RootCubed/CALCKS/Paper/assets/060306 015b (10).jpg

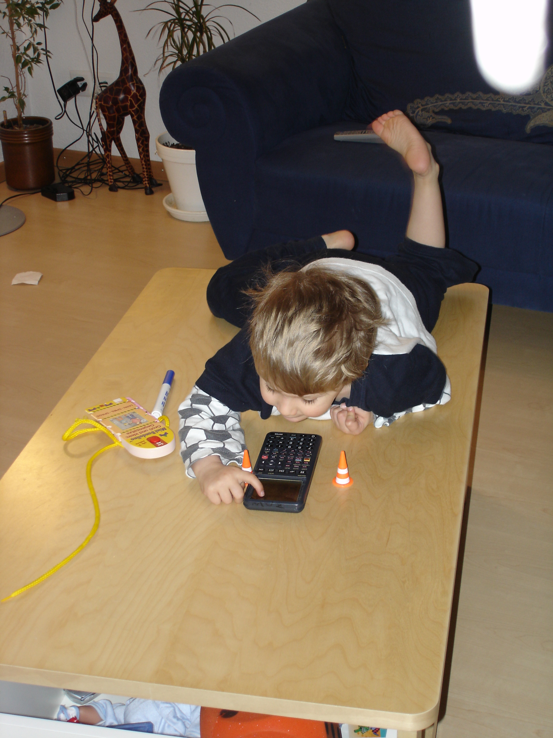
Paper/assets/060306 015b (10).jpg
