RootCubed/CALCKS/Paper/assets/background.jpg

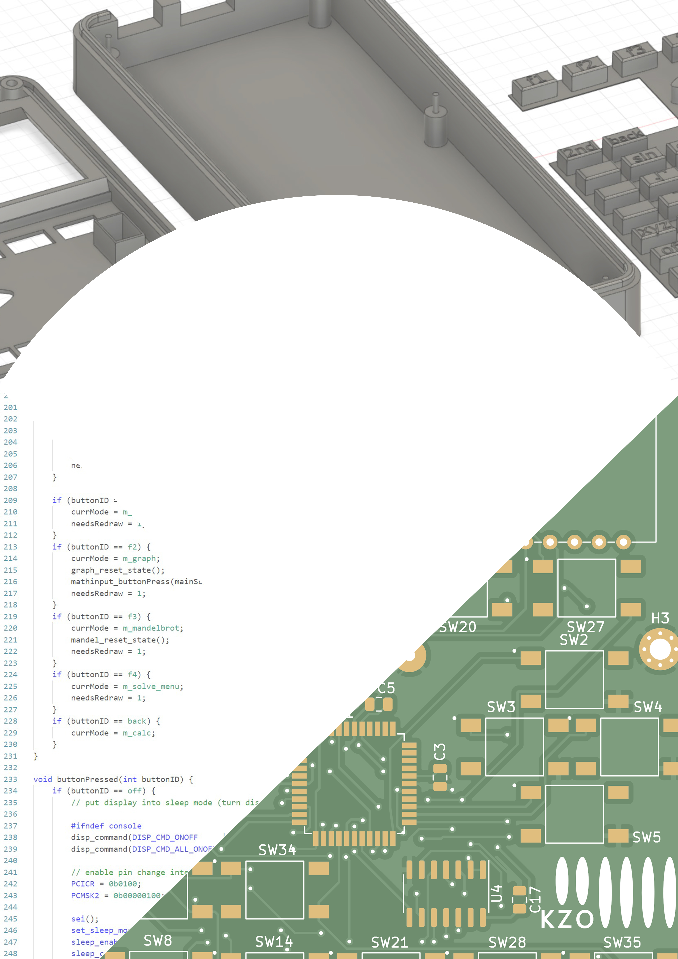
Paper/assets/background.jpg
