RootCubed/CALCKS/Paper/assets/breadboard.jpg

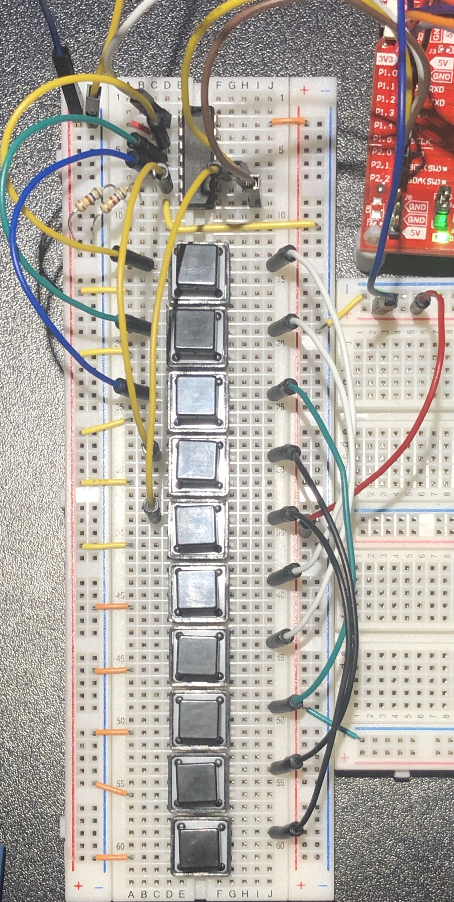
Paper/assets/breadboard.jpg
