RootCubed/CALCKS/Paper/assets/calc_example_calculation_l.png

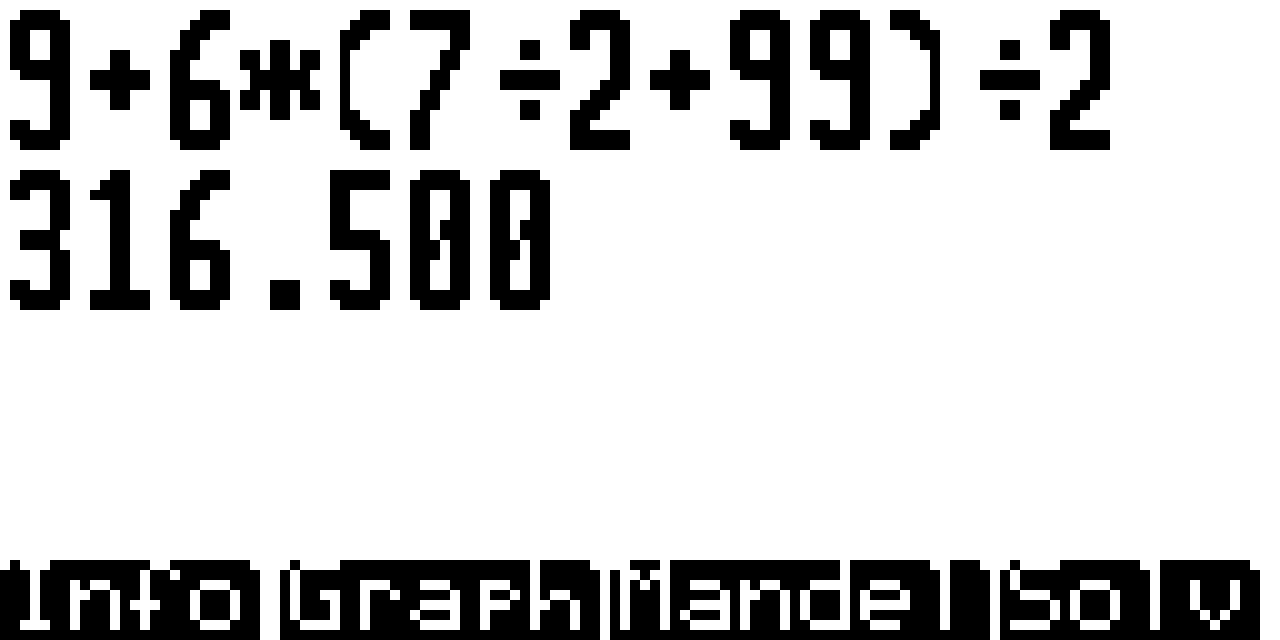
Paper/assets/calc_example_calculation_l.png
