RootCubed/CALCKS/Paper/assets/dogm128.png

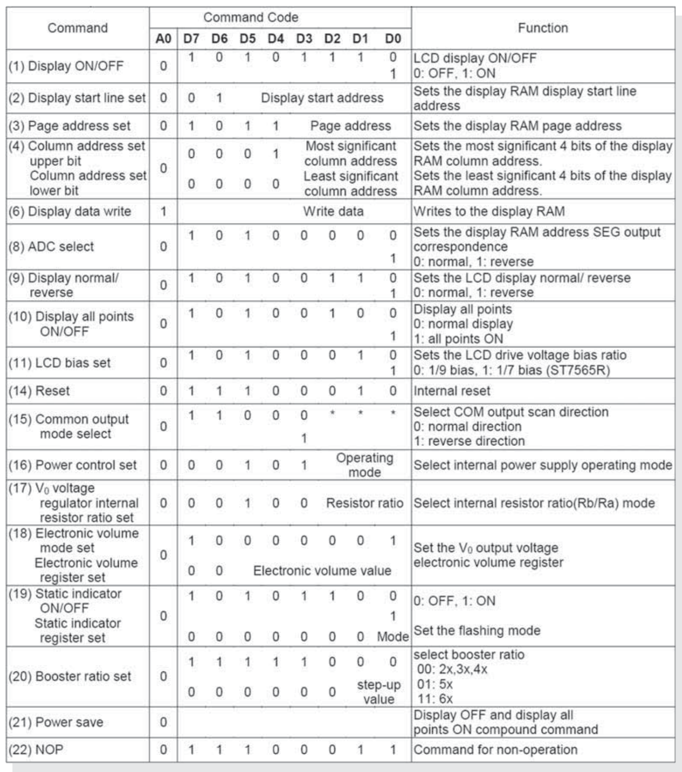
Paper/assets/dogm128.png
