RootCubed/CALCKS/Paper/assets/IMG_5603.JPG

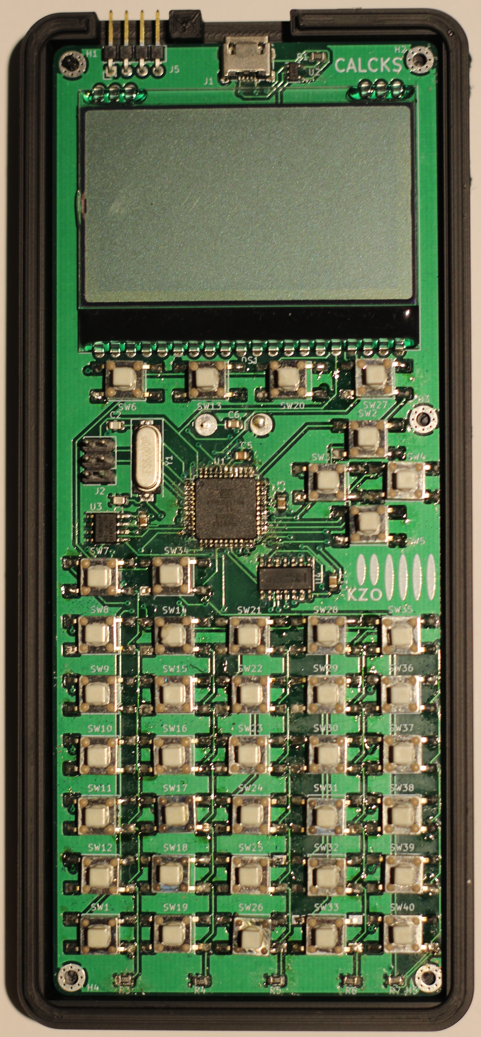
Paper/assets/IMG_5603.JPG
