RootCubed/CALCKS/Paper/assets/IMG_5605.JPG

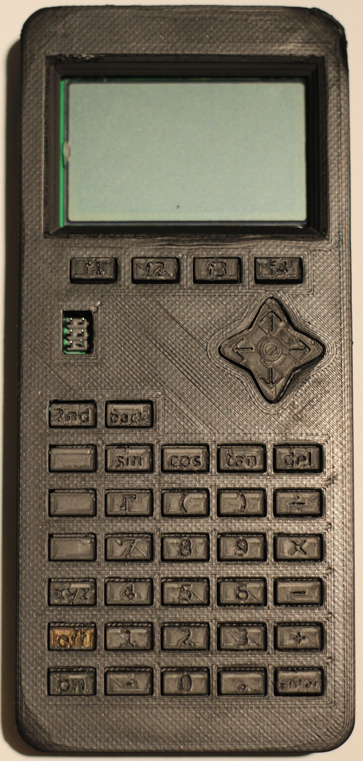
Paper/assets/IMG_5605.JPG
