RootCubed/CALCKS/Paper/assets/Screenshot 2020-10-16 181640.jpg

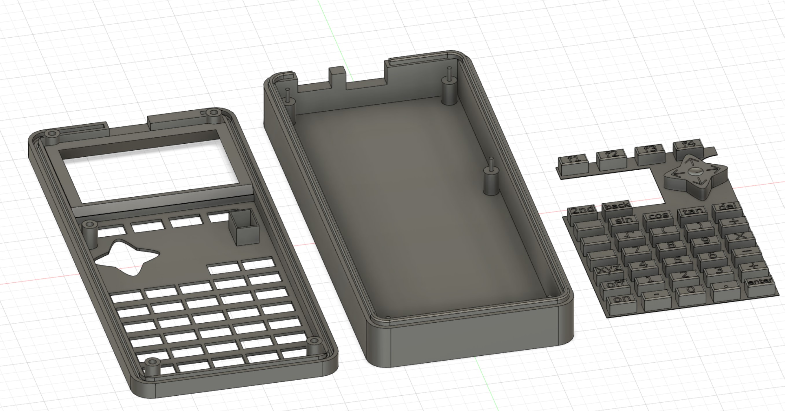
Paper/assets/Screenshot 2020-10-16 181640.jpg
