RootCubed/CALCKS/Paper/assets/screenshotvscode.jpg

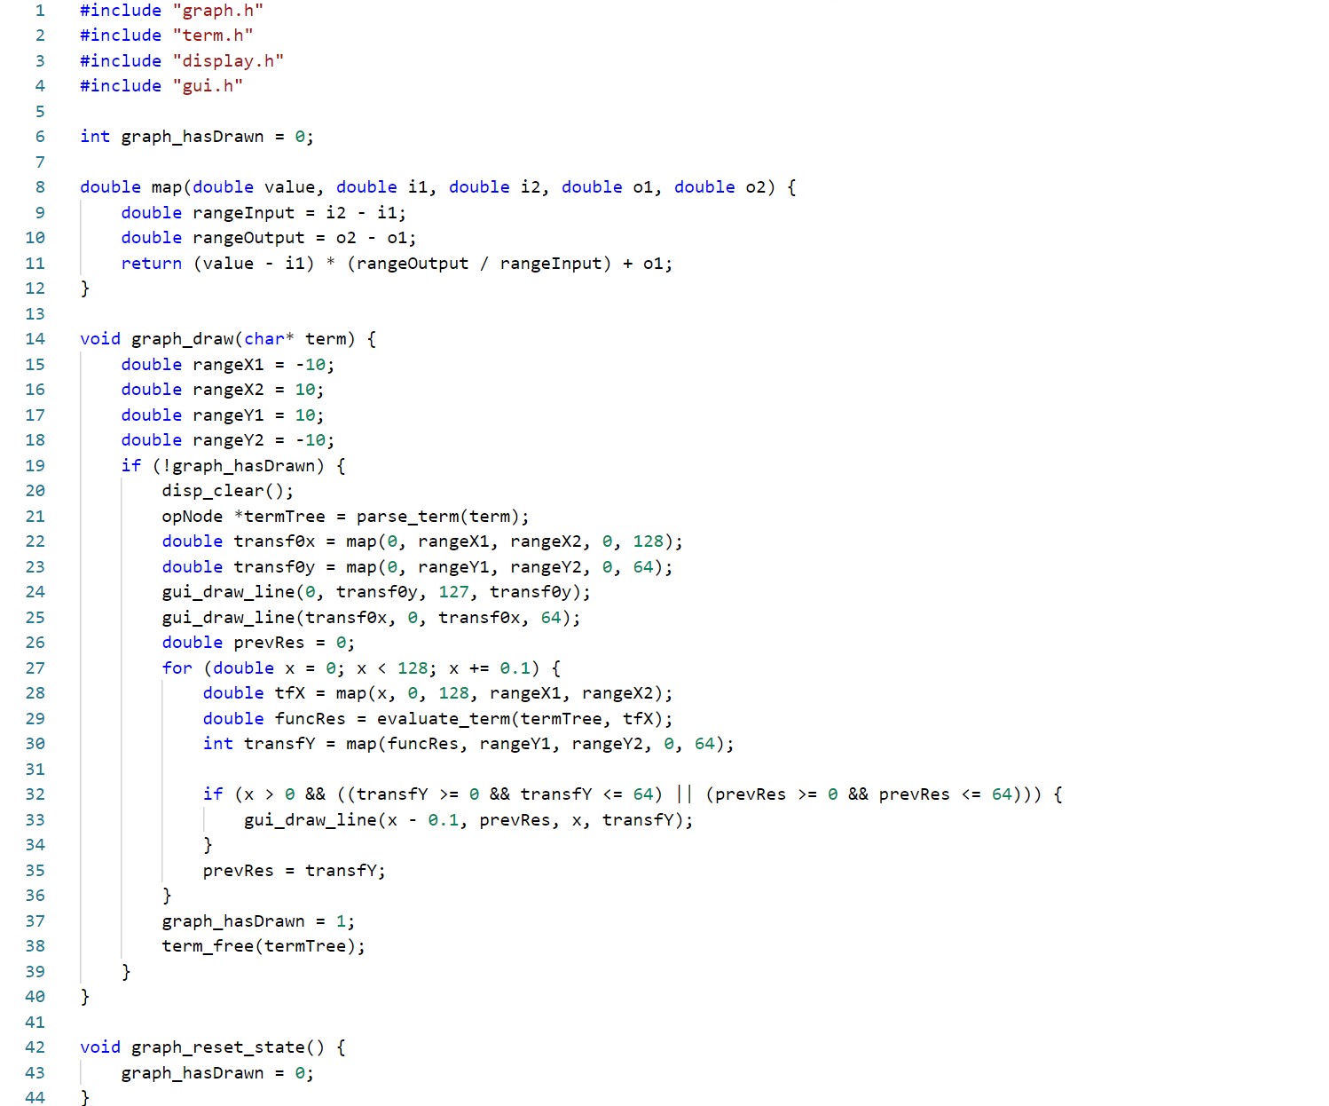
Paper/assets/screenshotvscode.jpg
