RootCubed/CALCKS/Paper/assets/vscodescreen2.jpg

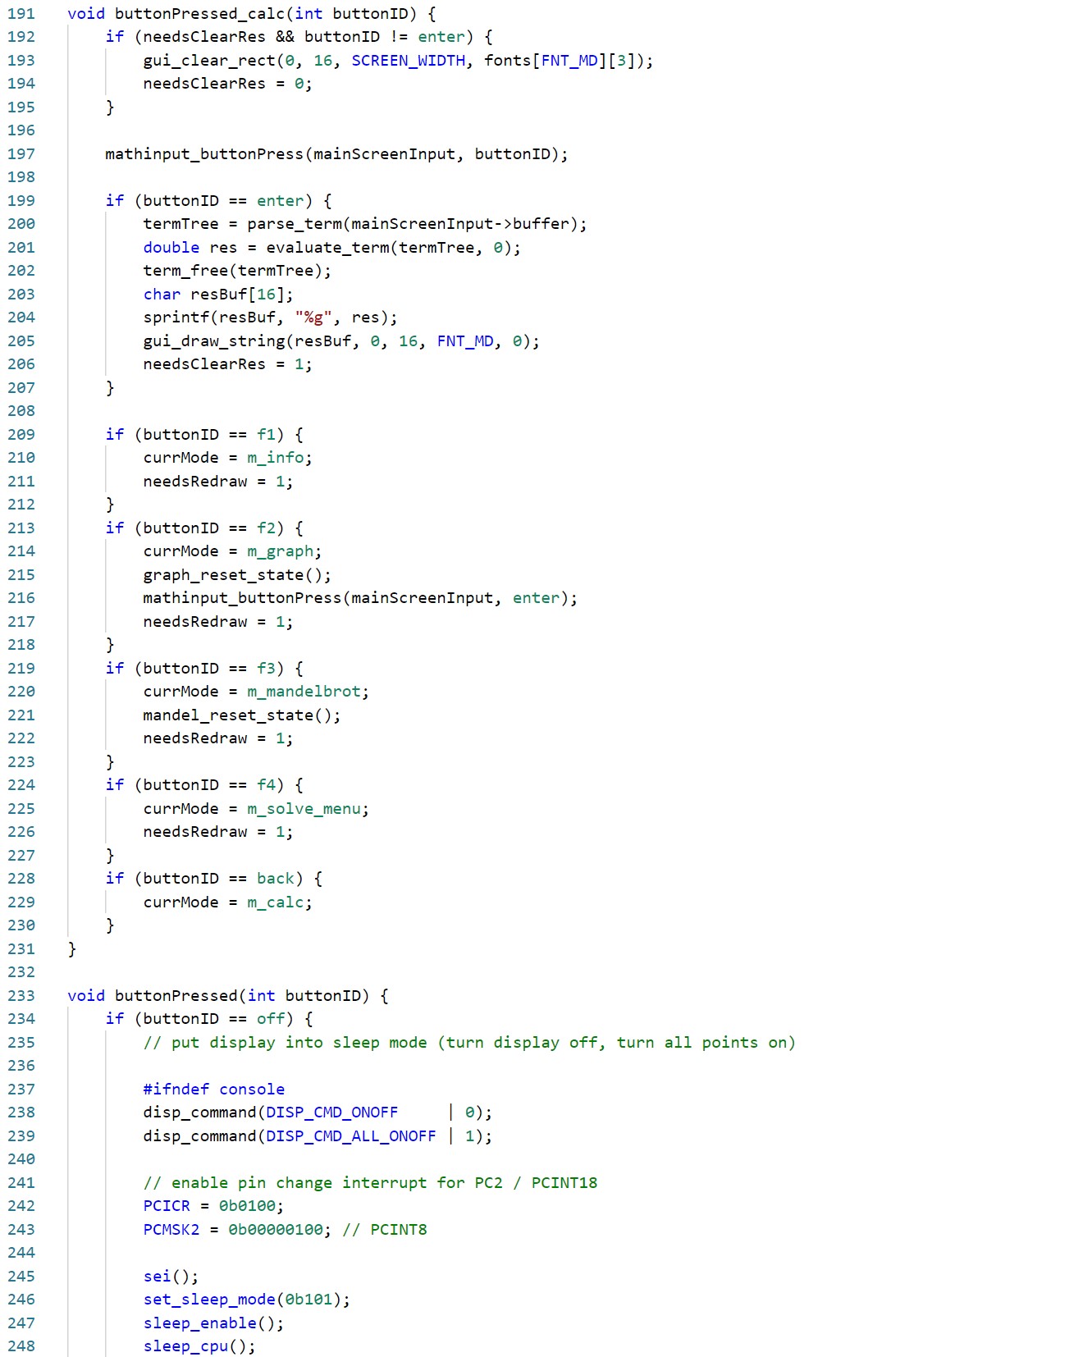
Paper/assets/vscodescreen2.jpg
