RootCubed/CALCKS/Hardware/3D Models/C_Top.stl

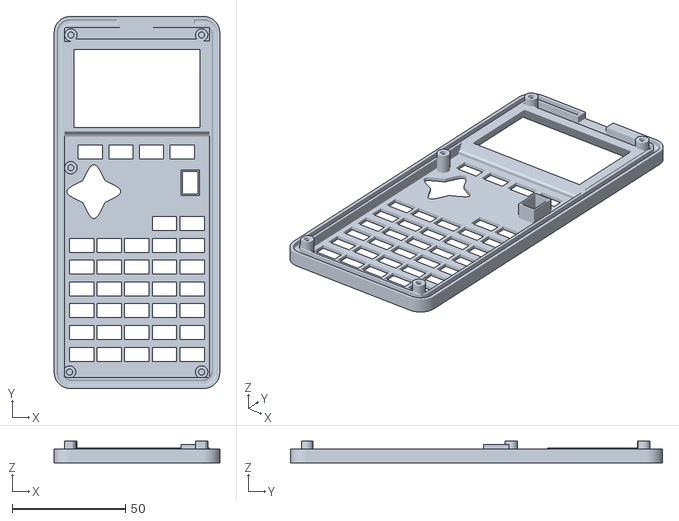
[picture p43: CAD file, 2020-11-02]
Hardware/3D Models/C_Top.stl
73.0 x 164.0 x 9.50
