RootCubed/CALCKS/Hardware/CALCKS/Downloaded Footprints/TL3301SPFxxxxG.stp

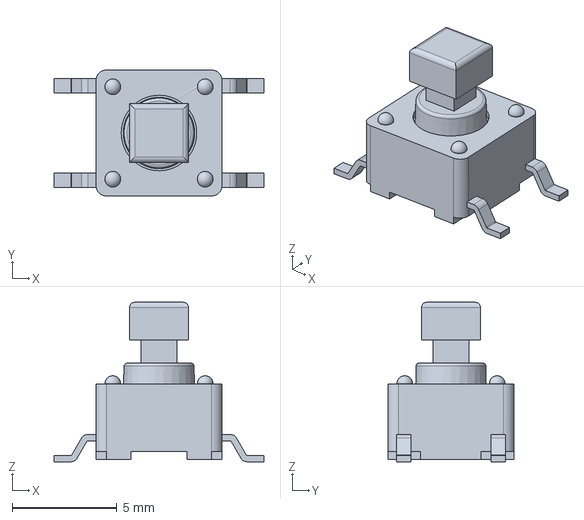
[picture p44: CAD file, 2020-06-26]
Hardware/CALCKS/Downloaded Footprints/TL3301SPFxxxxG.stp
10.0 x 6.00 x 7.60 mm
