RootCubed/CALCKS/Hardware/3D Models/C_Button_Pressers.stl

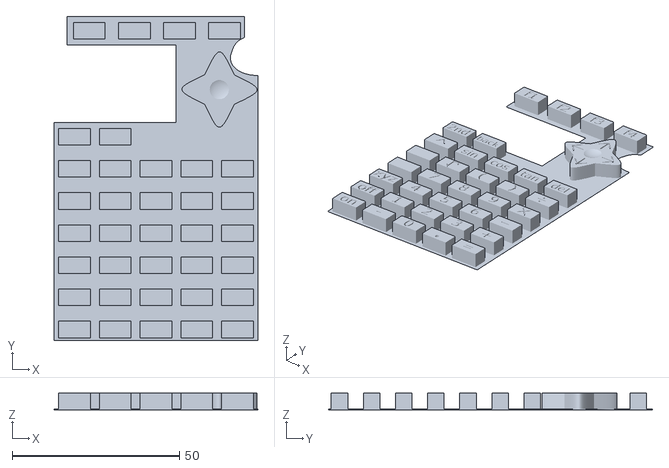
[picture p45: CAD file, 2020-11-02]
Hardware/3D Models/C_Button_Pressers.stl
60.8 x 96.8 x 5.00
