RootCubed/CALCKS/Hardware/3D Models/C_Bottom.stl

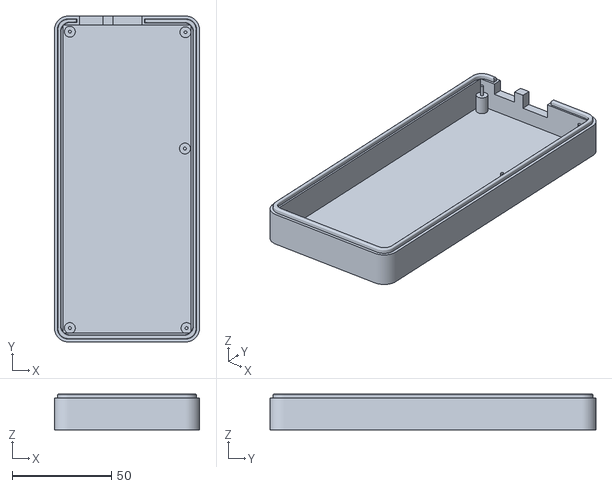
[picture p46: CAD file, 2020-11-02]
Hardware/3D Models/C_Bottom.stl
73.0 x 164.0 x 18.0
