RootCubed/CALCKS/Paper/assets/schematic.pdf

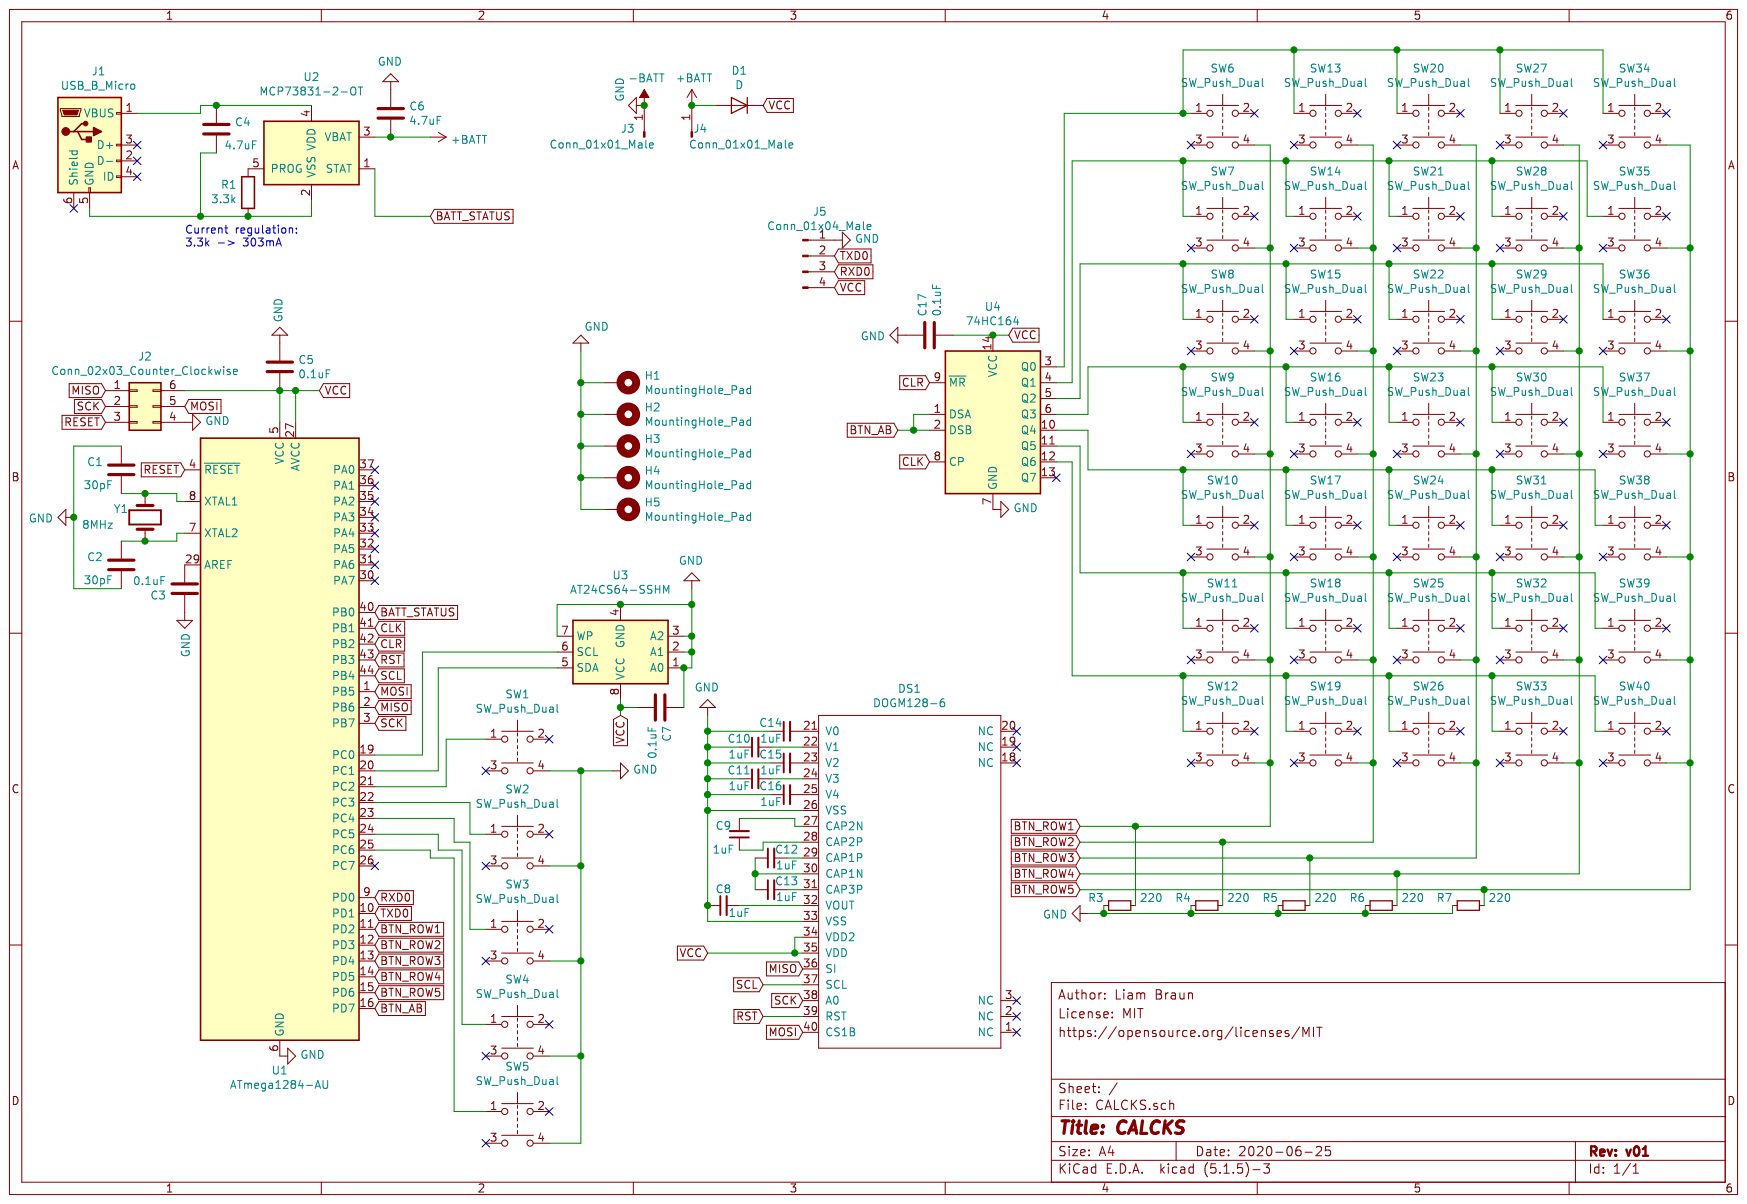
[picture p47: page 1]
