RootCubed/CALCKS/Hardware/CALCKS/CALCKS.kicad_pcb

## KiCad design Hardware/CALCKS/CALCKS.kicad_pcb (2020-09-02)

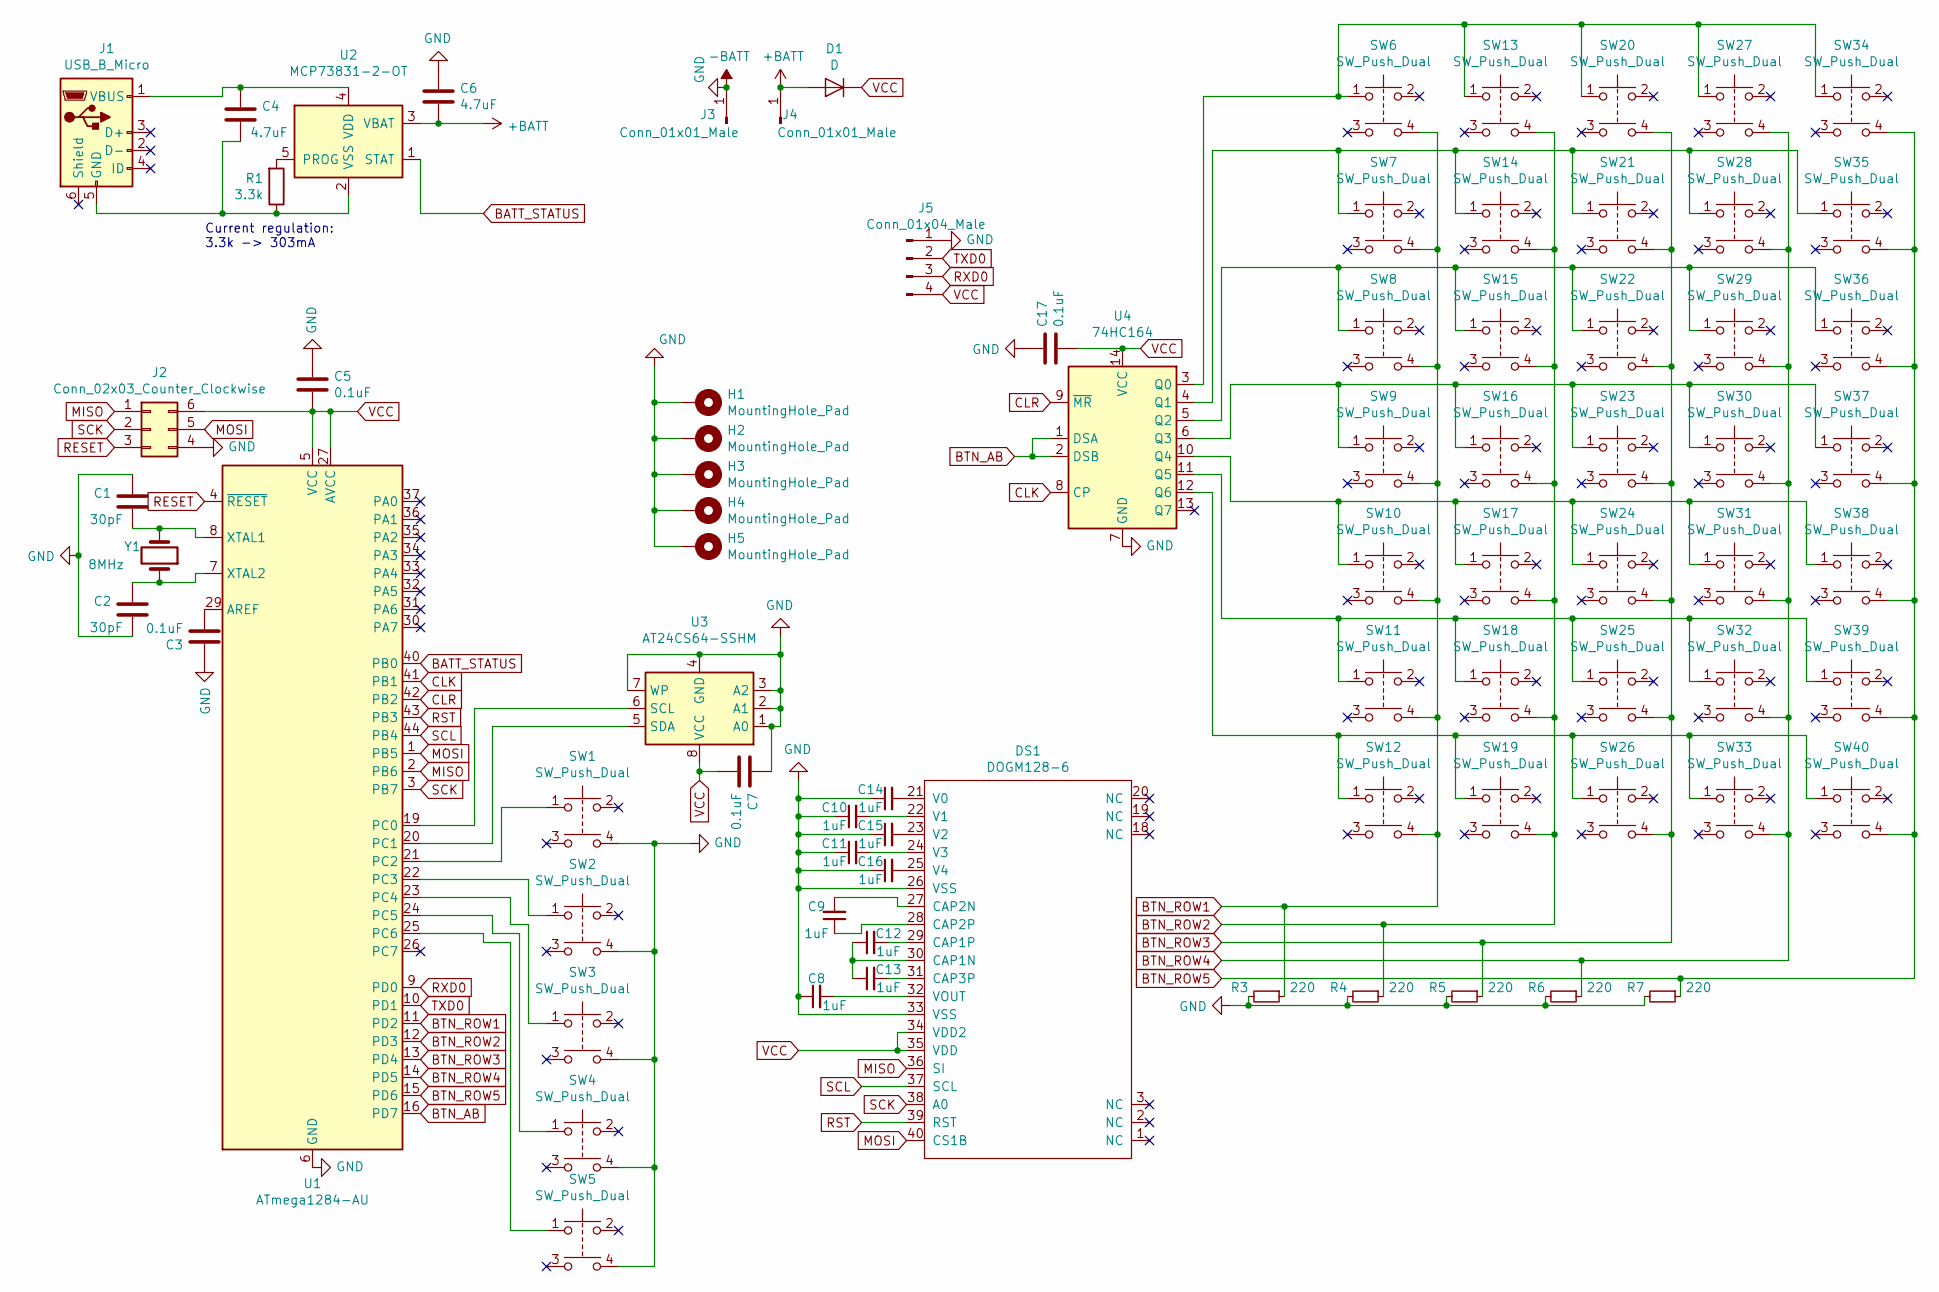
[picture p48: schematic CALCKS.sch]

Parts:
C1, C2: 30pF; C_0805_2012Metric
C3, C5, C7, C17: 0.1uF; C_0805_2012Metric
C4, C6: 4.7uF; C_0805_2012Metric
C8, C9, C10, C11, C12, C13, C14, C15, C16: 1uF; C_0805_2012Metric
D1: D; D_SOD-323_HandSoldering
DS1: DOGM128-6; LCD_DOGM128-6
H1, H2, H3, H4, H5: MountingHole_Pad; MountingHole_2.2mm_M2_Pad_Via
J1: USB_B_Micro; USB_Micro-B_Wuerth_629105150521
J2: Conn_02x03_Counter_Clockwise; PinHeader_2x03_P2.54mm_Vertical
J3, J4: Conn_01x01_Male; SolderWirePad_1x01_Drill1.2mm
J5: Conn_01x04_Male; PinHeader_1x04_P2.54mm_Horizontal
R1: 3.3k; R_0805_2012Metric
R3, R4, R5, R6, R7: 220; R_0805_2012Metric
SW1, SW2, SW3, SW4, SW5, SW6, SW7, SW8, SW9, SW10, SW11, SW12, SW13, SW14, SW15, SW16, SW17, SW18, SW19, SW20, SW21, SW22, SW23, SW24, SW25, SW26, SW27, SW28, SW29, SW30, SW31, SW32, SW33, SW34, SW35, SW36, SW37, SW38, SW39, SW40: SW_Push_Dual; SW_TL3301SPF260QG
U1: ATmega1284-AU; TQFP-44_10x10mm_P0.8mm
U2: MCP73831-2-OT; SOT-23-5
U3: AT24CS64-SSHM; SOIC-8_3.9x4.9mm_P1.27mm
U4: 74HC164; SOIC-14_3.9x8.7mm_P1.27mm
Y1: 8MHz; Crystal_SMD_HC49-SD

Connections:
+BATT: C6.2, D1.2 (A), J4.1, U2.3 (VBAT)
-BATT: C1.2, C2.1, C3.1, C5.1, C6.1, C7.1, C8.1, C10.1, C11.1, C14.1, C15.1, C16.1, C17.1, DS1.26 (VSS), DS1.33 (VSS), H1.1, H2.1, H3.1, H4.1, H5.1, J2.4, J3.1, J5.1, R3.2, R4.2, R5.2, R6.2, R7.2, SW1.4, SW2.4, SW3.4, SW4.4, SW5.4, U1.6 (GND), U1.18 (GND), U1.28 (GND), U1.39 (GND), U3.1 (A0), U3.2 (A1), U3.3 (A2), U3.4 (GND), U3.7 (WP), U4.7 (GND)
BATT_STATUS: U1.40 (PB0), U2.1 (STAT)
BTN_AB: U1.16 (PD7), U4.1 (DSA), U4.2 (DSB)
BTN_ROW1: R3.1, SW6.4, SW7.4, SW8.4, SW9.4, SW10.4, SW11.4, SW12.4, U1.11 (PD2)
BTN_ROW2: R4.1, SW13.4, SW14.4, SW15.4, SW16.4, SW17.4, SW18.4, SW19.4, U1.12 (PD3)
BTN_ROW3: R5.1, SW20.4, SW21.4, SW22.4, SW23.4, SW24.4, SW25.4, SW26.4, U1.13 (PD4)
BTN_ROW4: R6.1, SW27.4, SW28.4, SW29.4, SW30.4, SW31.4, SW32.4, SW33.4, U1.14 (PD5)
BTN_ROW5: R7.1, SW34.4, SW35.4, SW36.4, SW37.4, SW38.4, SW39.4, SW40.4, U1.15 (PD6)
CLK: U1.41 (PB1), U4.8 (CP)
CLR: U1.42 (PB2), U4.9 (~MR)
MISO: DS1.36 (SI), J2.1, U1.2 (PB6)
MOSI: DS1.40 (CS1B), J2.5, U1.1 (PB5)
unnamed: C1.1, U1.8 (XTAL1), Y1.2
unnamed: C2.2, U1.7 (XTAL2), Y1.1
unnamed: C3.2, U1.29 (AREF)
unnamed: C4.1, J1.1 (VBUS), U2.4 (VDD)
unnamed: C4.2, J1.5 (GND), R1.1, U2.2 (VSS)
unnamed: C8.2, DS1.32 (VOUT)
unnamed: C9.1, DS1.28 (CAP2P)
unnamed: C9.2, DS1.27 (CAP2N)
unnamed: C10.2, DS1.22 (V1)
unnamed: C11.2, DS1.24 (V3)
unnamed: C12.1, C13.1, DS1.30 (CAP1N)
unnamed: C12.2, DS1.29 (CAP1P)
unnamed: C13.2, DS1.31 (CAP3P)
unnamed: C14.2, DS1.21 (V0)
unnamed: C15.2, DS1.23 (V2)
unnamed: C16.2, DS1.25 (V4)
unnamed: R1.2, U2.5 (PROG)
unnamed: SW1.1, U1.21 (PC2)
unnamed: SW2.1, U1.22 (PC3)
unnamed: SW3.1, U1.23 (PC4)
unnamed: SW4.1, U1.24 (PC5)
unnamed: SW5.1, U1.25 (PC6)
unnamed: SW10.1, SW17.1, SW24.1, SW31.1, SW38.1, U4.10 (Q4)
unnamed: SW11.1, SW18.1, SW25.1, SW32.1, SW39.1, U4.11 (Q5)
unnamed: SW12.1, SW19.1, SW26.1, SW33.1, SW40.1, U4.12 (Q6)
unnamed: SW6.1, SW13.1, SW20.1, SW27.1, SW34.1, U4.3 (Q0)
unnamed: SW7.1, SW14.1, SW21.1, SW28.1, SW35.1, U4.4 (Q1)
unnamed: SW8.1, SW15.1, SW22.1, SW29.1, SW36.1, U4.5 (Q2)
unnamed: SW9.1, SW16.1, SW23.1, SW30.1, SW37.1, U4.6 (Q3)
unnamed: U1.19 (PC0), U3.6 (SCL)
unnamed: U1.20 (PC1), U3.5 (SDA)
RESET: J2.3, U1.4 (~RESET)
RST: DS1.39 (RST), U1.43 (PB3)
RXD0: J5.3, U1.9 (PD0)
SCK: DS1.38 (A0), J2.2, U1.3 (PB7)
SCL: DS1.37 (SCL), U1.44 (PB4)
TXD0: J5.2, U1.10 (PD1)
VCC: C5.2, C7.2, C17.2, D1.1 (K), DS1.34 (VDD2), DS1.35 (VDD), J2.6, J5.4, U1.5 (VCC), U1.17 (VCC), U1.27 (AVCC), U1.38 (VCC), U3.8 (VCC), U4.14 (VCC)

Notes on the sheet:
Current regulation: 3.3k -> 303mA

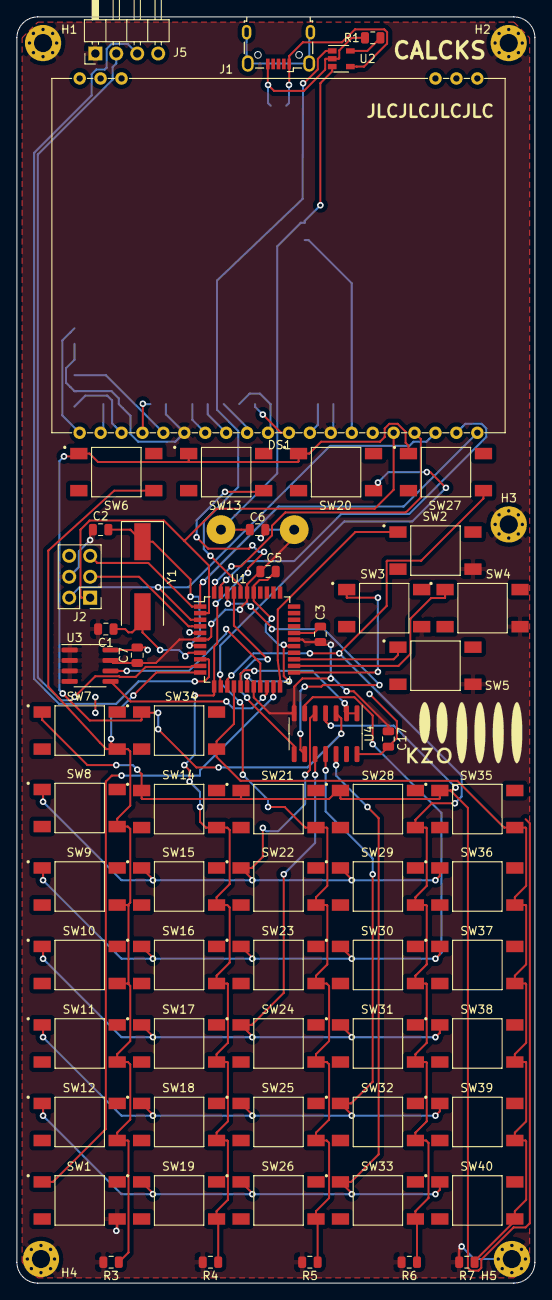
[picture p49: board CALCKS.kicad_pcb from above]

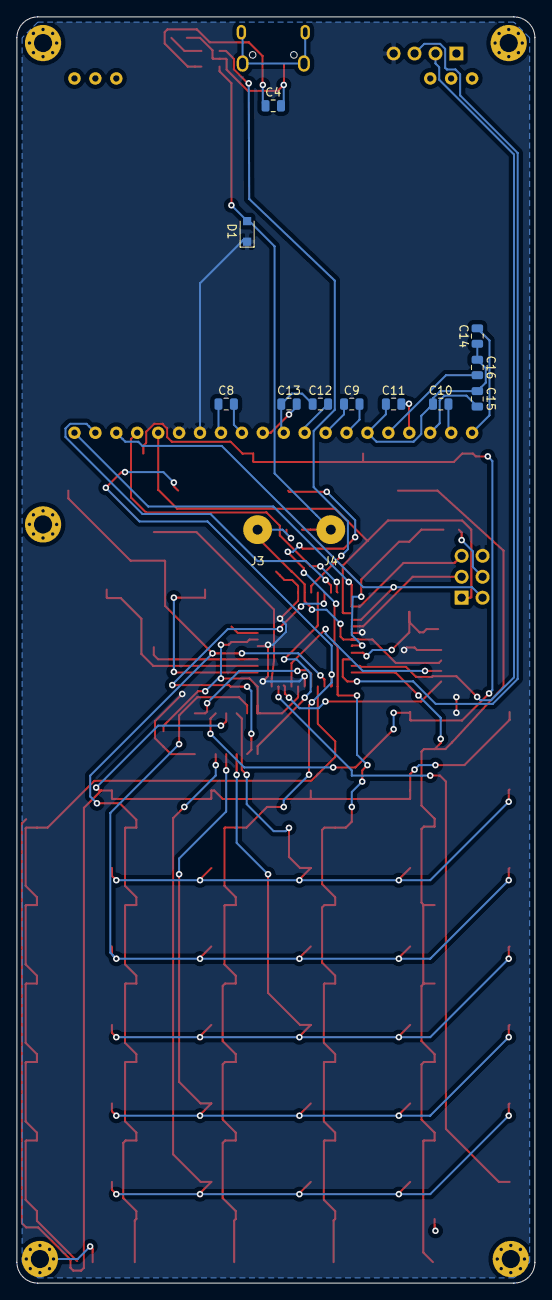
[picture p50: board CALCKS.kicad_pcb from below]

Board: 2 copper layers, 62.9 x 153.7 mm, 80 parts (13 on the bottom side), 51 nets.
