RootCubed/CALCKS/Firmware/common/EEPROMLocs.h

#ifndef EEPROMLOCS_H_
#define EEPROMLOCS_H_

#define EEPROM_FONT_NUM_CHARS 82
#define EEPROM_STARTUP 0
#define EEPROM_STARTUP_LEN 1024

#define EEPROM_FONT_6x7 (EEPROM_STARTUP + EEPROM_STARTUP_LEN)
#define EEPROM_FONT_6x7_LEN (7 * EEPROM_FONT_NUM_CHARS)

#define EEPROM_FONT_8x16 (EEPROM_FONT_6x7 + EEPROM_FONT_6x7_LEN)
#define EEPROM_FONT_8x16_LEN (16 * EEPROM_FONT_NUM_CHARS)

#endif /* EEPROMLOCS_H_ */
