RootCubed/CALCKS/Firmware/avr/display.c

#include <avr/io.h>
#include <avr/eeprom.h>
#include <stdio.h>
#include <string.h>

#include "../common/display.h"

char buffer[128*8];
int page = 0;
int xPos = 0;

void disp_initialize() {
    DDRB |= DISP_CS | DISP_RESET | DISP_A0 | DISP_SCL | DISP_SI;

    PORTB &= ~DISP_SCL;
    PORTB &= ~DISP_CS; // chip select active low

    PORTB &= ~DISP_RESET; // reset display
    PORTB |= DISP_RESET;

    for (int i = 0; i < DISP_INIT_LEN; i++) {
        disp_command(disp_initSequence[i]);
    }
}

void disp_clear() {
    int page, col;
    for (page = 8; page >= 0; page--) {
        disp_setPage(page);
        disp_setXPos(0);
        for (col = 127; col >= 0; col--) {
            disp_data(0x00);
        }
    }
}

void disp_data(char cmd) {
    PORTB |= DISP_A0;
    
    if (realX < 0 || realX > 128 || page < 0 || page > 7) return;
    disp_sendByte(cmd);

    // update buffer
    buffer[page * 128 + realX] = cmd;
	xPos++;
}

void disp_update_data(char cmd) {
    PORTB |= DISP_A0;

    if (realX < 0 || realX > 128 || page < 0 || page > 7) return;
    disp_sendByte(cmd | buffer[page * 128 + realX]);

    // update buffer
    buffer[page * 128 + realX] |= cmd;
	xPos++;
}

void disp_remove_data(char cmd) {
    PORTB |= DISP_A0;

    if (realX < 0 || realX > 128 || page < 0 || page > 7) return;
    disp_sendByte(cmd & buffer[page * 128 + realX]);

    // update buffer
    buffer[page * 128 + realX] &= cmd;
	xPos++;
}

void disp_command(char cmd) {
    PORTB &= ~DISP_A0;
    disp_sendByte(cmd);

    // update buffer
    if ((cmd & 0xF0) == DISP_CMD_PAGE) {
		page = cmd & 0xF;
	}
	if ((cmd & 0xF0) == DISP_CMD_COL_LSB) {
		xPos &= 0b11110000;
		xPos |= (cmd & 0x0F);
	}
	if ((cmd & 0xF0) == DISP_CMD_COL_MSB) {
		xPos &= 0b00001111;
		xPos |= (cmd & 0x0F) << 4;
	}
}

void disp_sendByte(char data) {
    PORTB &= ~DISP_CS; // chip select active low
    for (int i = 7; i >= 0; i--) {
        if ((data >> i) & 1) {
            PORTB |= DISP_SI;
        } else {
            PORTB &= ~DISP_SI;
        }

        PORTB &= ~DISP_SCL;
        PORTB |= DISP_SCL;
    }
    PORTB |= DISP_CS; // chip select active low
}
