RootCubed/CALCKS/Firmware/common/types.h

#ifndef TYPES_H_
#define TYPES_H_

#define u8 unsigned char
#define u16 unsigned short
#define u32 unsigned int
#define u64 unsigned long

#define s8 signed char
#define s16 signed short
#define s32 signed int
#define s64 signed long

#endif /* TYPES_H_ */
