RootCubed/CALCKS/(commit log)

2020-05-06 Add buttons for temporary support for a new button
2020-05-07 First few steps in Autodesk EAGLE
    [CALCKS.kicad_pcb, CALCKS.sch]
2020-05-09 Font expansion + button overlay
2020-05-14 remove unused code, small bug fix
    [display.c]
2020-05-17 Upload EEPROM data via UART/USB
2020-05-17 make buttons look a bit nicer
2020-05-19 Tweak button appearance
2020-06-26 Add PCB progress from yesterday
    [CALCKS.kicad_pcb, CALCKS.sch, TL3301SPFxxxxG.stp]
2020-06-28 PCB routing
    [CALCKS.kicad_pcb, CALCKS.sch]
2020-06-30 small changes
    [CALCKS.kicad_pcb, CALCKS.sch]
2020-06-30 Final changes to PCB before sending it off
    [CALCKS.csv, CALCKS.kicad_pcb, CALCKS.sch]
2020-08-28 Version 2 of PCB
    [CALCKS.kicad_pcb, CALCKS.sch]
2020-08-30 Start work on expression parsing Currently, terms with +, -, * and / are able to be parsed.
2020-09-01 Various changes for upgrading to PCB
2020-09-02 fix merge issues, increase baud rate
    [buttons.c, gui.c, main.c]
2020-09-02 Re-add version 2 of Hardware
    [BOM.csv, CALCKS.kicad_pcb, CALCKS.sch]
2020-09-02 Make buttons.c compatible with new hardware
2020-09-04 some small changes - added bmp388 (currently commented out) - Charging / not charging
2020-09-09 Add more buttons, remove some debugging
2020-10-12 Able to parse brackets, improve battery display
2020-10-12 Add more buttons to emulator
2020-10-12 Make button related things more extensible
2020-10-25 Fix buffer overflow in bufStr
    [display.c, display.h, gui.c, gui.h, main.c, mathinput.c, solver.c]
2020-10-27 Support for decimals, add button grid SVG
2020-11-01 Many bug fixes, added scrolling in term - Sometimes, the emulator showed certain pixel arrangements incorrectly: The root cause of this was that when the buffer contained 0x0A, the emulator would out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
    [buttons.c, buttons.h, display.c, display.h, graph.c, gui.c, gui.h, main.c]
2020-11-01 Add back tab buttons
2020-11-01 fix battery icon
2020-11-01 Add used RAM info for memory leak checking
    [main.c]
2020-11-02 Add delete button & a couple of bug fixes
    [buttons.c, buttons.h, main.c, mathinput.c, solver.c]
2020-11-02 Fix displaying of inverted characters
    [gui.c, solver.c]
2020-11-02 Add latest 3D models
    [C_Bottom.stl, C_Button_Pressers.stl, C_Top.stl]
2020-11-02 Fix edge case with brackets
    [term.c]
2020-11-02 Quick bug fix for delete button
    [mathinput.c]
2020-11-03 Fix bug in syntax checking & add it to all menus
    [graph.c, main.c, mathinput.c, solver.c, solver.h, term.c]
2020-11-05 Syntax checking fix, (maybe?) fix memory leak
    [term.c]
2020-11-23 use regular threads instead of windows threads
2020-11-23 Some small bug fixes
    [graph.c, gui.c, mathinput.c, solver.c, term.c]
2021-05-08 Add trigonometric function buttons
2021-05-08 Fix bug in unit test, simplify dummy operations
    [term.c, term.h]
2021-11-06 Fix some compiler warnings
    [display.c, gui.c, gui.h, mathinput.c, mathinput.h, term.c]
2021-11-08 Fix key input for button presses
2021-11-09 Add UART functionality
2021-11-09 Add sources for paper
    [BOM.csv]
