RootCubed/CALCKS/(notices)

Notices in the files:
Hardware/CALCKS/CALCKS.kicad_pcb:
License: MIT
